Ekstazaa/Synthesizer-with-1V-input-and-LFO/KiCad-files/Synthesizer.kicad_pcb

## KiCad design KiCad-files/Synthesizer.kicad_pcb (2026-01-29)

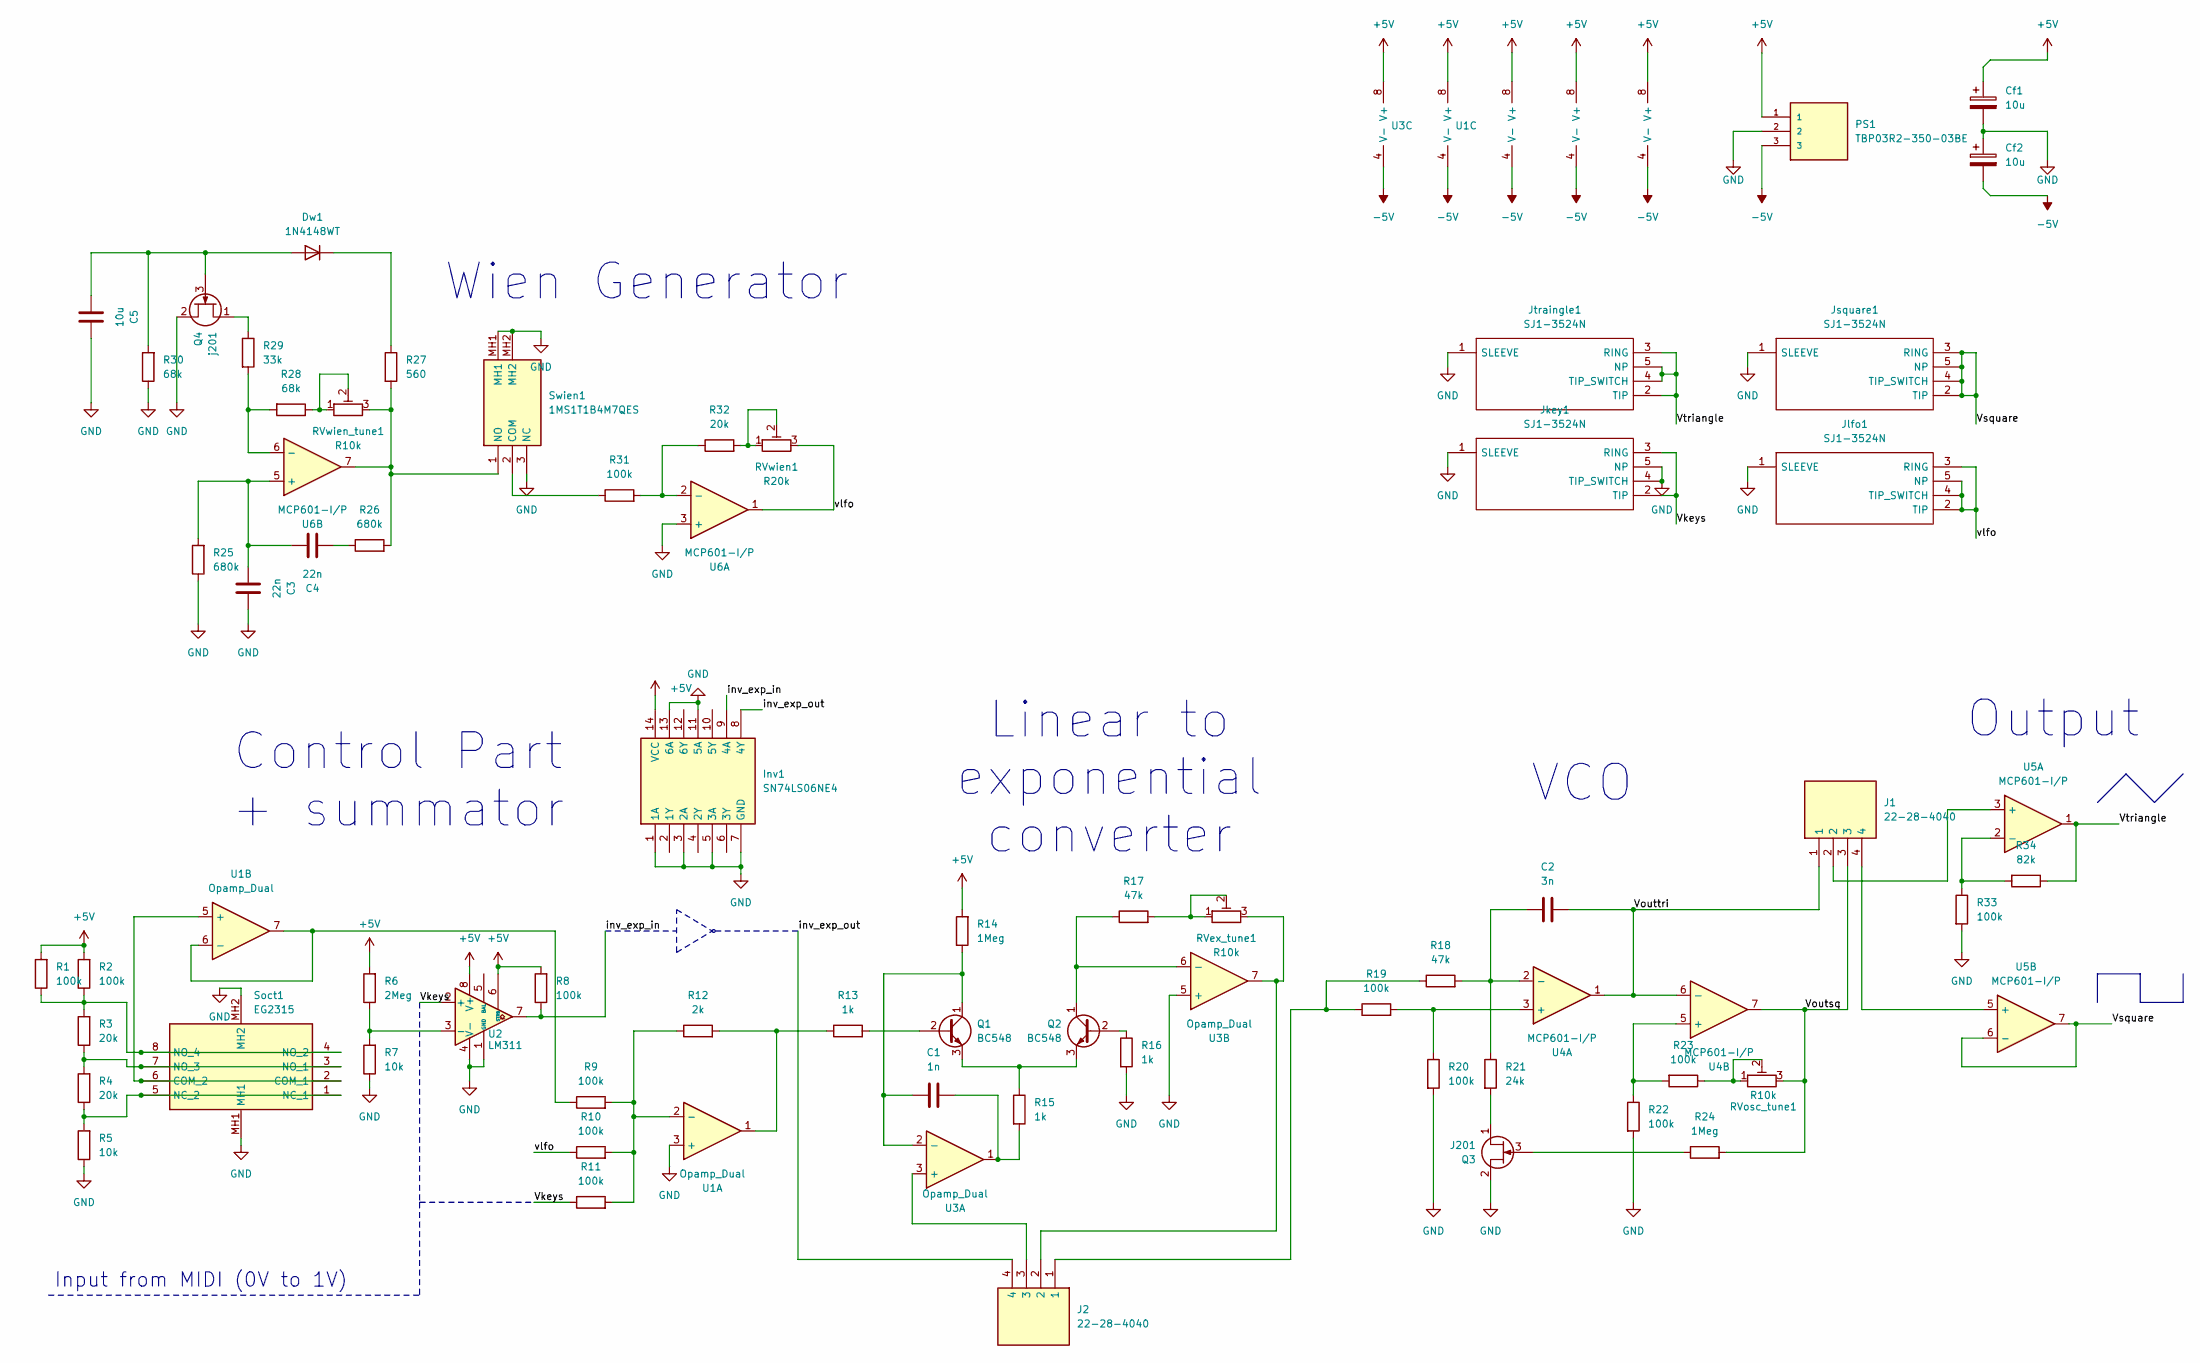
[picture p24: schematic Synthesizer.kicad_sch]

Parts:
C1: 1n; C_0805_2012Metric
C2: 3n; C_0805_2012Metric; Tolerance 1%
C3, C4: 22n; C_0805_2012Metric
C5: 10u; C_0805_2012Metric
Cf1, Cf2: 10u; CP_Radial_Tantal_D4.5mm_P2.50mm
Dw1: 1N4148WT; D_SOD-523
Inv1: SN74LS06NE4; DIP794W53P254L1930H508Q14N; Mouser Part Number 595-SN74LS06NE4
J1, J2: 22-28-4040; HDRV4W66P0X254_1X4_1016X249X838P; Manufacturer_Part_Number 22-28-4040
Jkey1: SJ1-3524N; SJ13524N; Mouser Part Number 490-SJ1-3524N
Jlfo1: SJ1-3524N; SJ13524N; Mouser Part Number 490-SJ1-3524N
Jsquare1: SJ1-3524N; SJ13524N; Mouser Part Number 490-SJ1-3524N
Jtraingle1: SJ1-3524N; SJ13524N; Mouser Part Number 490-SJ1-3524N
PS1: TBP03R2-350-03BE; CUI_TBP03R2-350-03BE; PARTREV 1.0
Q1, Q2: BC548; TO-92_Inline
Q3: J201; TO-92_Inline
Q4: j201; TO-92_Inline
R1, R2, R8, R9, R10, R11, R19, R20, R22, R23, R31, R33: 100k; R_0603_1608Metric; Tolerance 1%
R3, R4, R32: 20k; R_0603_1608Metric; Tolerance 1%
R5, R7: 10k; R_0603_1608Metric; Tolerance 1%
R6: 2Meg; R_0603_1608Metric; Tolerance 1%
R12: 2k; R_0603_1608Metric; Tolerance 1%
R13, R15, R16: 1k; R_0603_1608Metric; Tolerance 1%
R14, R24: 1Meg; R_0603_1608Metric; Tolerance 1%
R17, R18: 47k; R_0603_1608Metric; Tolerance 1%
R21: 24k; R_0603_1608Metric; Tolerance 1%
R25, R26: 680k; R_0603_1608Metric; Tolerance 1%
R27: 560; R_0603_1608Metric; Tolerance 1%
R28, R30: 68k; R_0603_1608Metric; Tolerance 1%
R29: 33k; R_0603_1608Metric; Tolerance 1%
R34: 82k; R_0603_1608Metric; Tolerance 1%
RVex_tune1: R10k; Potentiometer_ACP_CA9-H5_Horizontal
RVosc_tune1: R10k; Potentiometer_ACP_CA9-H5_Horizontal
RVwien1: R20k; Potentiometer_Alps_RK163_Single_Horizontal
RVwien_tune1: R10k; Potentiometer_ACP_CA9-H5_Horizontal
Soct1: EG2315; Manufacturer_Part_Number EG2315
Swien1: 1MS1T1B4M7QES; Mouser Part Number 118-1MS1T1B4M7QES
U1, U3: Opamp_Dual; DIP-8_W7.62mm
U2: LM311; DIP-8_W7.62mm
U4, U5, U6: MCP601-I/P; DIP-8_W7.62mm

Connections:
+5V: Cf1.1, Inv1.14 (VCC), PS1.1, R1.2, R2.2, R6.2, R8.2, R14.2, U1.8 (V+), U2.6 (STRB), U2.8 (V+), U3.8 (V+), U4.8 (V+), U5.8 (V+), U6.8 (V+)
-5V: Cf2.2, PS1.3, U1.4 (V-), U3.4 (V-), U4.4 (V-), U5.4 (V-), U6.4 (V-)
/Vkeys: Jkey1.2 (TIP), Jkey1.3 (RING), R11.1, U2.2 (+)
/Voutsq: J1.3, R24.2, RVosc_tune1.3, U4.7
/Vouttri: C2.2, J1.1, U4.1, U4.6 (-)
/Vsquare: Jsquare1.2 (TIP), Jsquare1.3 (RING), Jsquare1.4 (TIP_SWITCH), Jsquare1.5 (NP), U5.6 (-), U5.7
/Vtriangle: Jtraingle1.2 (TIP), Jtraingle1.3 (RING), Jtraingle1.4 (TIP_SWITCH), Jtraingle1.5 (NP), R34.1, U5.1
/inv_exp_in: Inv1.9 (4A), R8.1, U2.7
/inv_exp_out: Inv1.8 (4Y), J2.4
/vlfo: Jlfo1.2 (TIP), Jlfo1.3 (RING), Jlfo1.4 (TIP_SWITCH), Jlfo1.5 (NP), R10.1, RVwien1.3, U6.1
GND: C3.2, C5.2, Cf1.2, Cf2.1, Inv1.1 (1A), Inv1.3 (2A), Inv1.5 (3A), Inv1.7 (GND), Inv1.11 (5A), Inv1.13 (6A), Jkey1.1 (SLEEVE), Jkey1.4 (TIP_SWITCH), Jkey1.5 (NP), Jlfo1.1 (SLEEVE), Jsquare1.1 (SLEEVE), Jtraingle1.1 (SLEEVE), PS1.2, Q3.2 (S), Q4.2 (S), R5.1, R7.1, R16.2, R20.2, R22.2, R25.1, R30.1, R33.2, Soct1.MH1, Soct1.MH2, Swien1.3 (NC), Swien1.MH1, Swien1.MH2, U1.3 (+), U2.1 (GND), U2.4 (V-), U3.5 (+), U6.3 (+)
unnamed: C1.2, R15.2, U3.1
unnamed: C4.1, R26.1
unnamed: C5.1, Dw1.2 (A), Q4.3 (G), R30.2
unnamed: Dw1.1 (K), R27.1
unnamed: J2.1, R18.1, R19.1
unnamed: J2.2, RVex_tune1.3, U3.7
unnamed: Q1.2 (B), R13.2
unnamed: C1.1, Q1.1 (C), R14.1, U3.2 (-)
unnamed: Q1.3 (E), Q2.3 (E), R15.1
unnamed: Q2.2 (B), R16.1
unnamed: Q2.1 (C), R17.1, U3.6 (-)
unnamed: Q3.1 (D), R21.2
unnamed: Q3.3 (G), R24.1
unnamed: Q4.1 (D), R29.1
unnamed: R12.2, R13.1, U1.1
unnamed: R17.2, RVex_tune1.1, RVex_tune1.2
unnamed: R23.1, RVosc_tune1.1, RVosc_tune1.2
unnamed: R28.1, RVwien_tune1.1, RVwien_tune1.2
unnamed: R32.2, RVwien1.1, RVwien1.2
unnamed: Soct1.2 (COM_1), Soct1.6 (COM_2), U1.5 (+)
unnamed: R4.1, R5.2, Soct1.1 (NC_1), Soct1.5 (NC_2)
unnamed: R3.1, R4.2, Soct1.3 (NO_1), Soct1.7 (NO_3)
unnamed: R1.1, R2.1, R3.2, Soct1.4 (NO_2), Soct1.8 (NO_4)
unnamed: R31.1, Swien1.2 (COM)
unnamed: R26.2, R27.2, RVwien_tune1.3, Swien1.1 (NO), U6.7
unnamed: R9.2, R10.2, R11.2, R12.1, U1.2 (-)
unnamed: R9.1, U1.6 (-), U1.7
unnamed: R6.1, R7.2, U2.3 (-)
unnamed: J2.3, U3.3 (+)
unnamed: R19.2, R20.1, U4.3 (+)
unnamed: C2.1, R18.2, R21.1, U4.2 (-)
unnamed: R22.1, R23.2, U4.5 (+)
unnamed: J1.2, U5.3 (+)
unnamed: R33.1, R34.2, U5.2 (-)
unnamed: J1.4, U5.5 (+)
unnamed: R31.2, R32.1, U6.2 (-)
unnamed: C3.1, C4.2, R25.2, U6.5 (+)
unnamed: R28.2, R29.2, U6.6 (-)

Notes on the sheet:
Output
Linear to exponential converter
Input from MIDI (0V to 1V)
Control Part + summator
Wien Generator
VCO

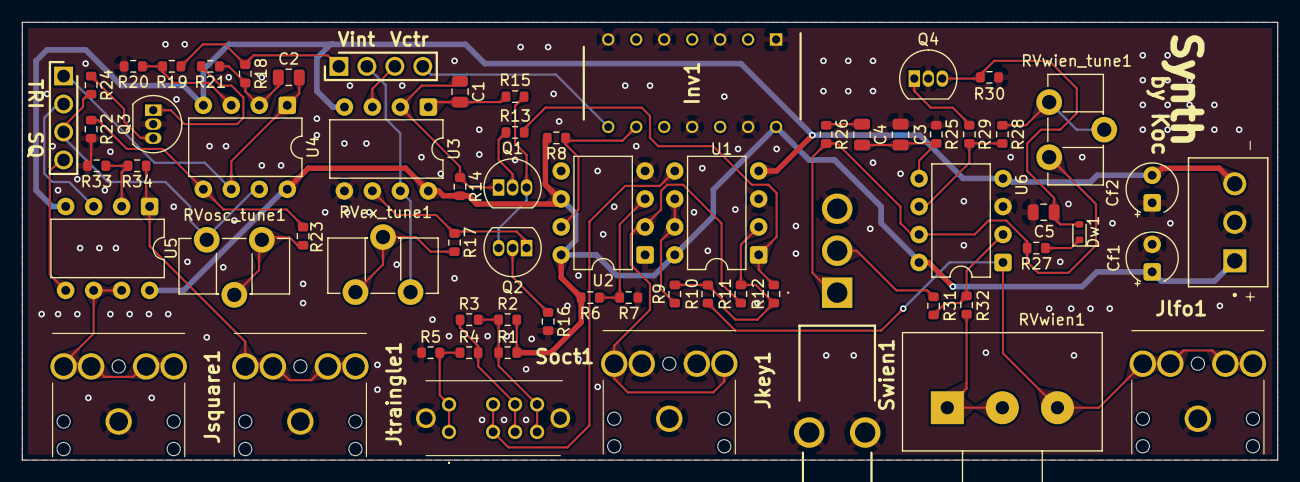
[picture p25: board Synthesizer.kicad_pcb from above]

Board: 2 copper layers, 114.0 x 39.8 mm, 66 parts (0 on the bottom side), 49 nets.
