Ekstazaa/Synthesizer-with-1V-input-and-LFO/(commit log)

2026-01-29 Update and rename VCO.kicad_pcb to Synthesizer.kicad_pcb
    [Synthesizer.kicad_pcb]
2026-01-29 Update and rename VCO.kicad_sch to Synthesizer.kicad_sch
    [Synthesizer.kicad_sch]
